anthonyzhou-1/3Dprinting/Z_Shaft_Clamp_v1.2.stl

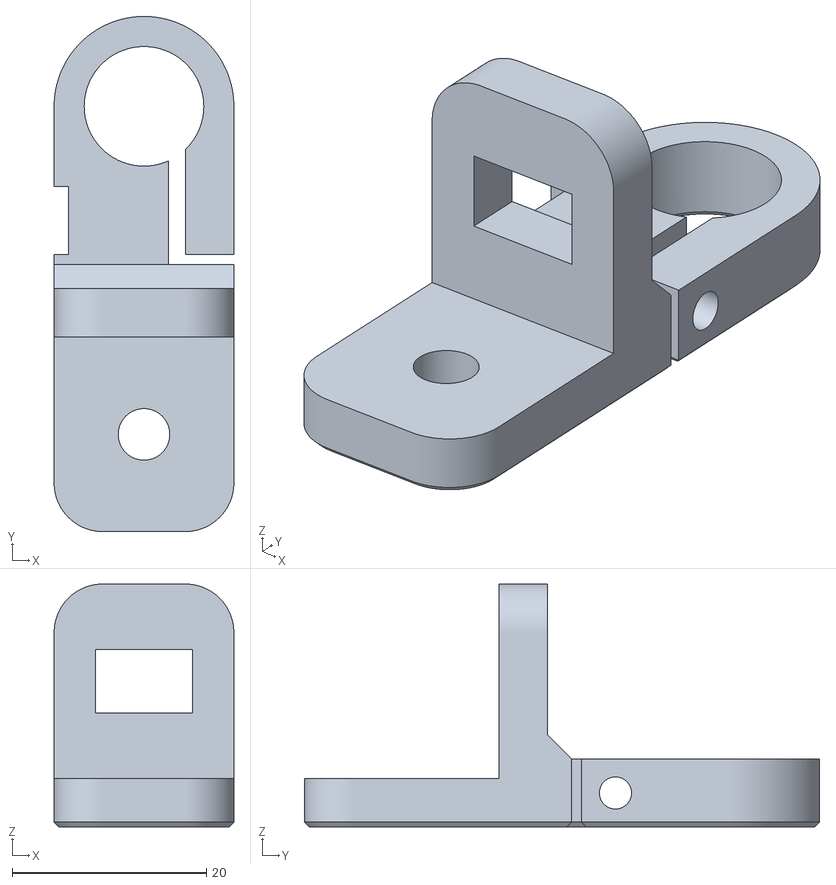
[picture p5: CAD file, 2020-04-30]
Z_Shaft_Clamp_v1.2.stl
18.5 x 53.0 x 25.0
