anthonyzhou-1/3Dprinting/Bowden_Knob.stl

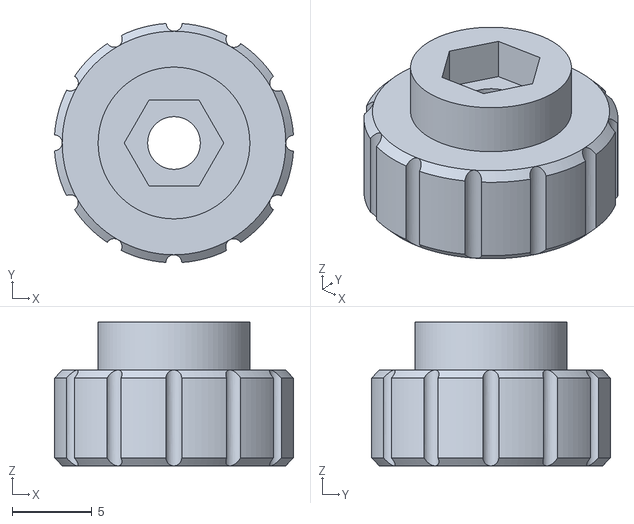
[picture p6: CAD file, 2020-04-30]
Bowden_Knob.stl
15.0 x 15.0 x 9.00
