anthonyzhou-1/3Dprinting/E3D_clamp.stl

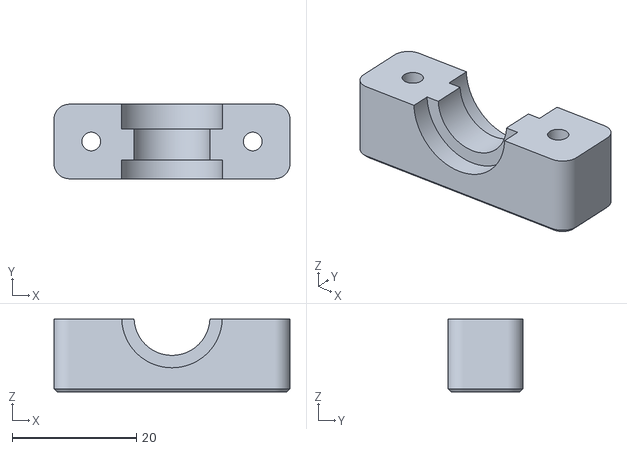
[picture p7: CAD file, 2020-04-30]
E3D_clamp.stl
38.0 x 12.0 x 11.8
