anthonyzhou-1/3Dprinting/Fan_Duct_v1.2.stl

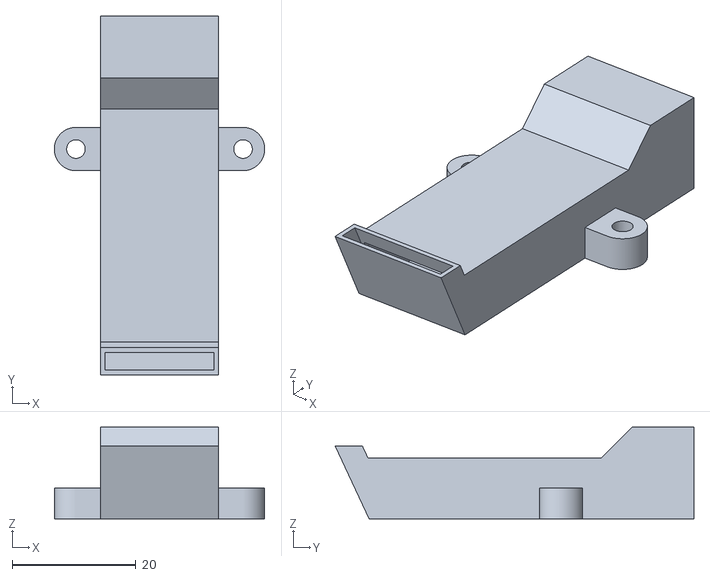
[picture p8: CAD file, 2020-04-30]
Fan_Duct_v1.2.stl
34.0 x 58.0 x 14.8
