anthonyzhou-1/3Dprinting/Z_EndStop_v1.2.stl

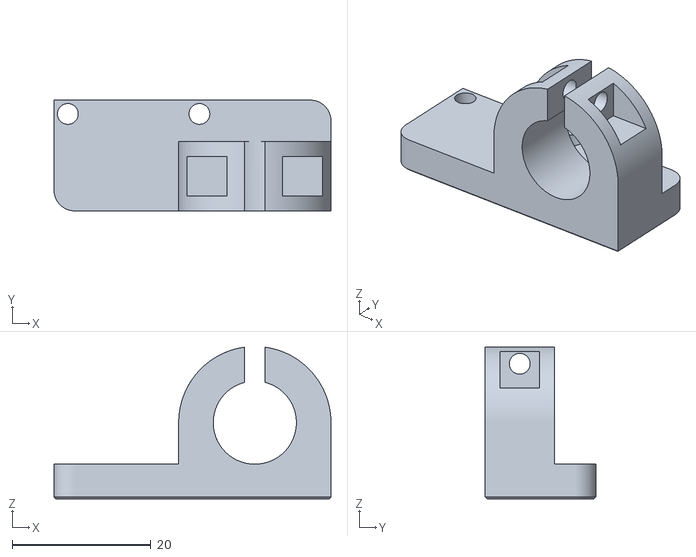
[picture p9: CAD file, 2020-04-30]
Z_EndStop_v1.2.stl
40.0 x 16.0 x 21.9
