anthonyzhou-1/3Dprinting/Z_EndStop_Adjust_v1.1.stl

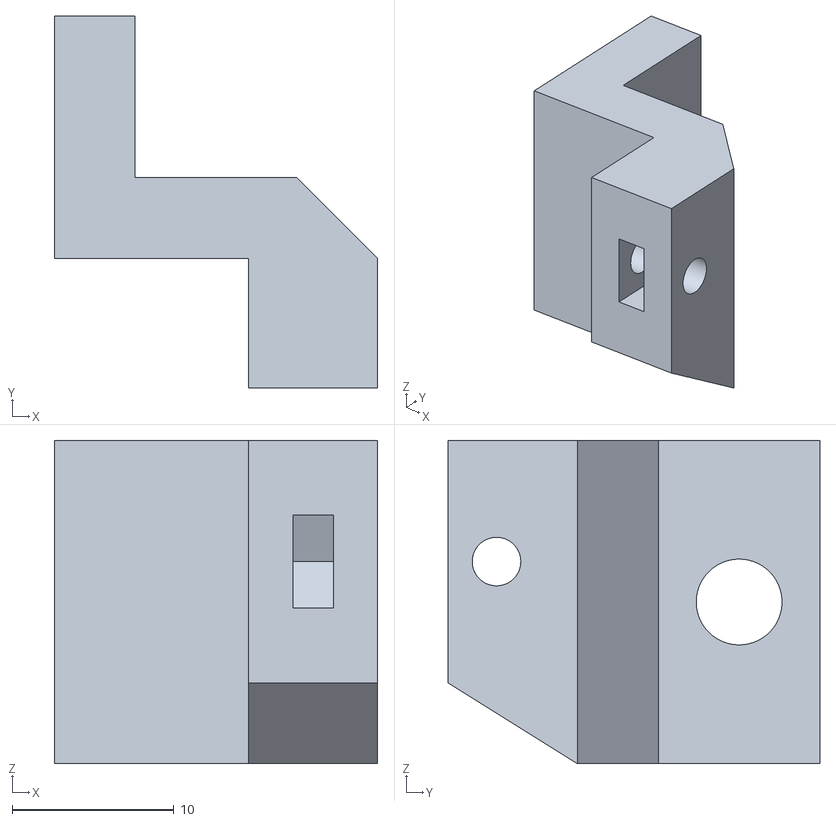
[picture p10: CAD file, 2020-04-30]
Z_EndStop_Adjust_v1.1.stl
20.0 x 23.0 x 20.0
