anthonyzhou-1/3Dprinting/XY_Motor_right.stl

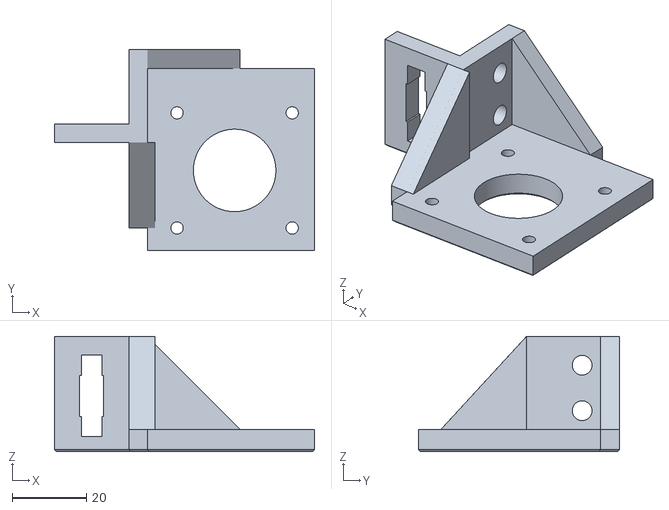
[picture p11: CAD file, 2020-04-30]
XY_Motor_right.stl
70.0 x 54.0 x 31.0
