anthonyzhou-1/3Dprinting/XY_Joiner_v1.1.stl

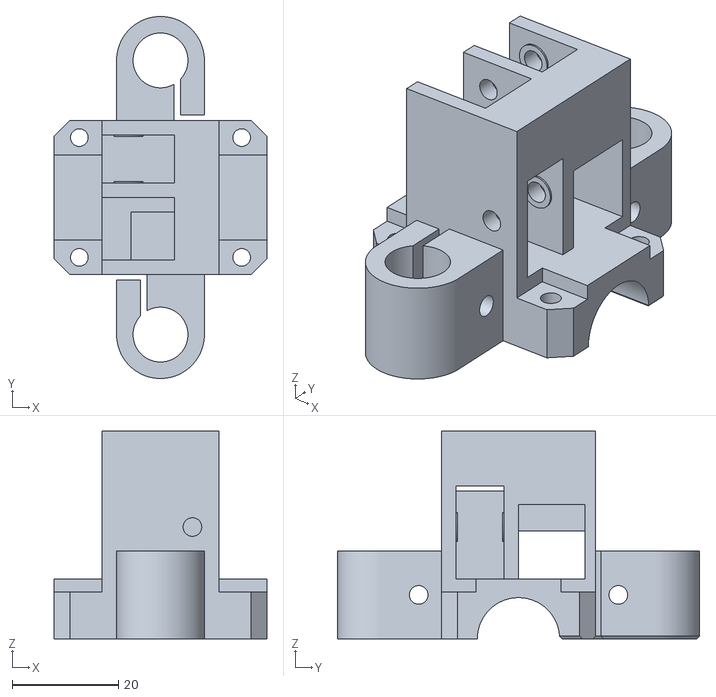
[picture p12: CAD file, 2020-04-30]
XY_Joiner_v1.1.stl
40.0 x 68.0 x 39.0
