anthonyzhou-1/3Dprinting/Y_EndStop.stl

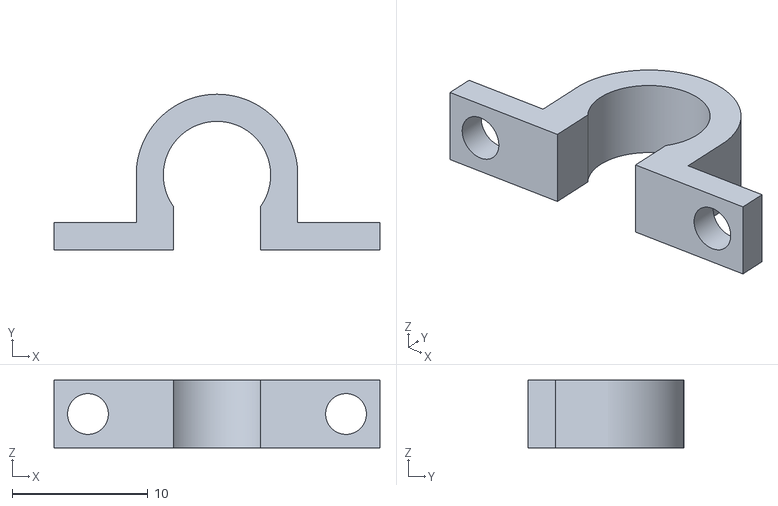
[picture p13: CAD file, 2020-04-30]
Y_EndStop.stl
24.0 x 11.4 x 5.00
