anthonyzhou-1/3Dprinting/X_Carriage_v1.2.stl

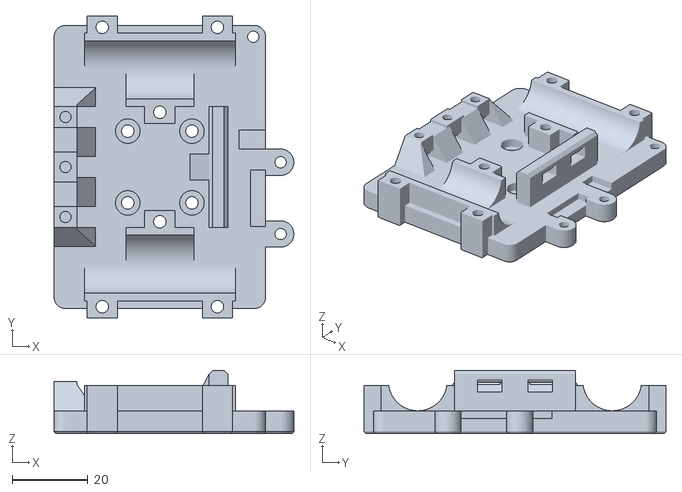
[picture p14: CAD file, 2020-04-30]
X_Carriage_v1.2.stl
63.5 x 80.0 x 16.8
