anthonyzhou-1/3Dprinting/Y_Shaft_Clamp.stl

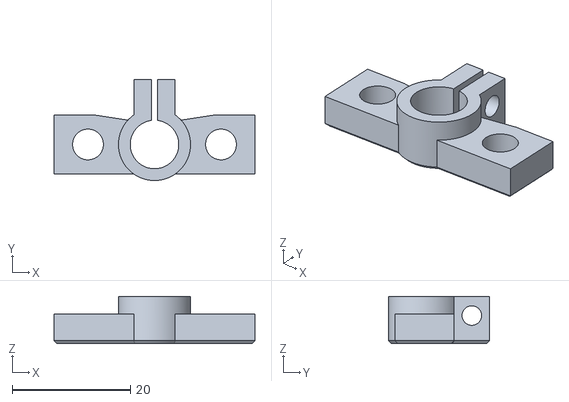
[picture p15: CAD file, 2020-04-30]
Y_Shaft_Clamp.stl
34.0 x 17.1 x 8.00
