anthonyzhou-1/3Dprinting/XY_Clamp_v1.1.stl

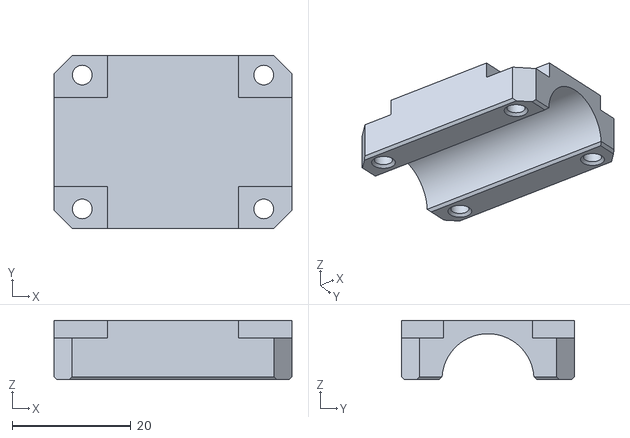
[picture p16: CAD file, 2020-04-30]
XY_Clamp_v1.1.stl
40.0 x 29.0 x 10.0
