anthonyzhou-1/3Dprinting/Z_Motor_v1.1.stl

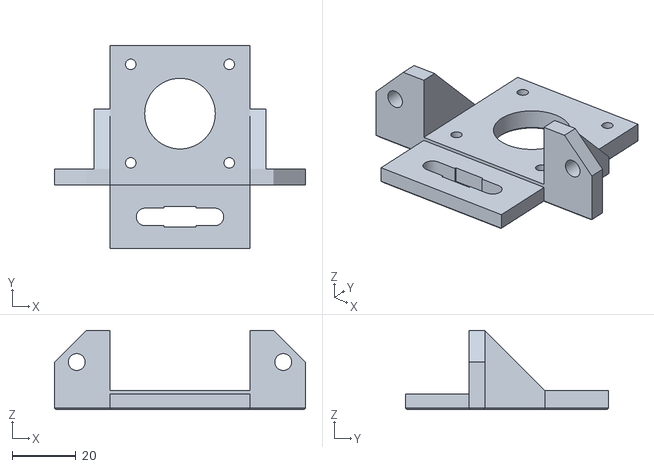
[picture p17: CAD file, 2020-04-30]
Z_Motor_v1.1.stl
79.0 x 64.0 x 25.0
