anthonyzhou-1/3Dprinting/Z_Carriage_clamp_v1.1.stl

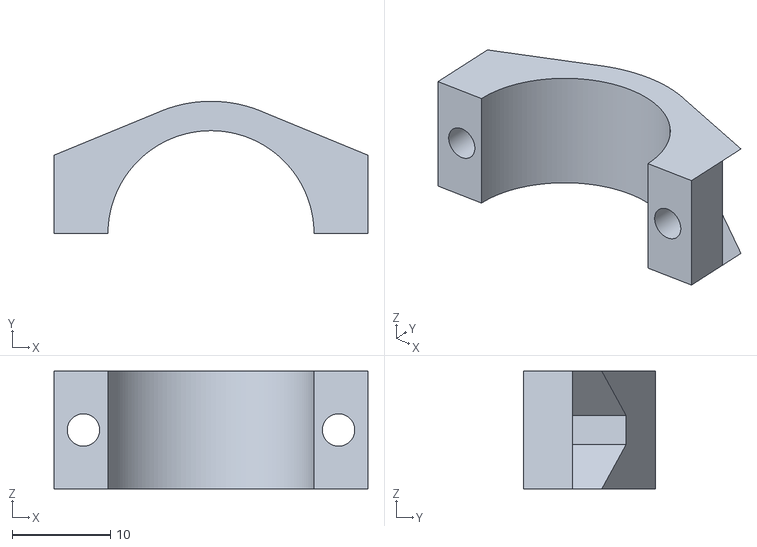
[picture p18: CAD file, 2020-04-30]
Z_Carriage_clamp_v1.1.stl
32.0 x 13.5 x 12.0
