anthonyzhou-1/3Dprinting/Bed_Support_v1.1.stl

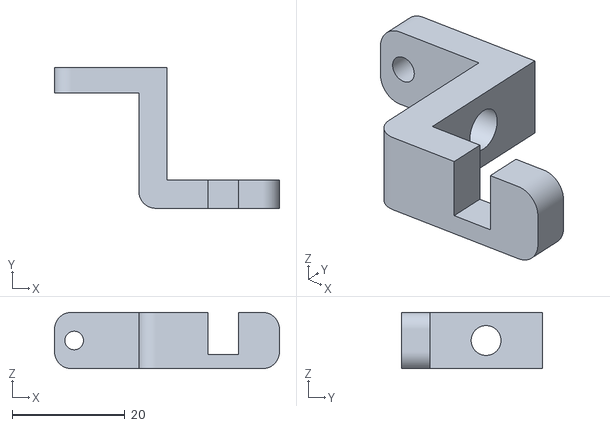
[picture p19: CAD file, 2020-04-30]
Bed_Support_v1.1.stl
40.0 x 25.0 x 10.0
