anthonyzhou-1/3Dprinting/Dual_bushing_holder.stl

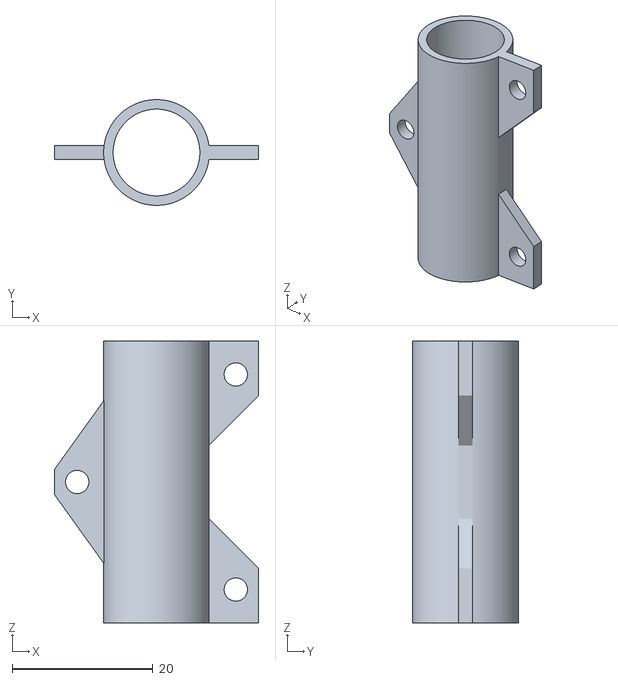
[picture p20: CAD file, 2020-04-30]
Dual_bushing_holder.stl
29.0 x 15.0 x 40.0
