anthonyzhou-1/3Dprinting/Bowden_Motor_v1.1.stl

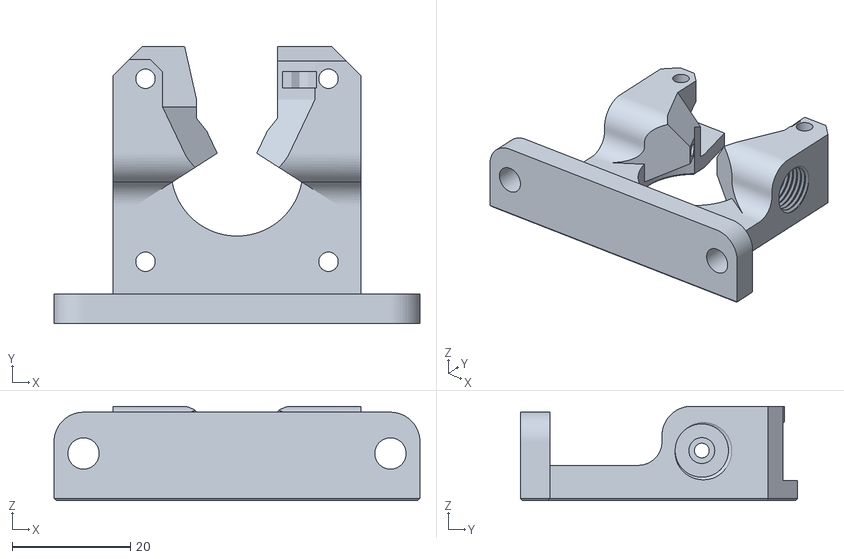
[picture p21: CAD file, 2020-04-30]
Bowden_Motor_v1.1.stl
62.0 x 47.0 x 16.0
