anthonyzhou-1/3Dprinting/Y_Shaft_Clamp_Left_Motor.stl

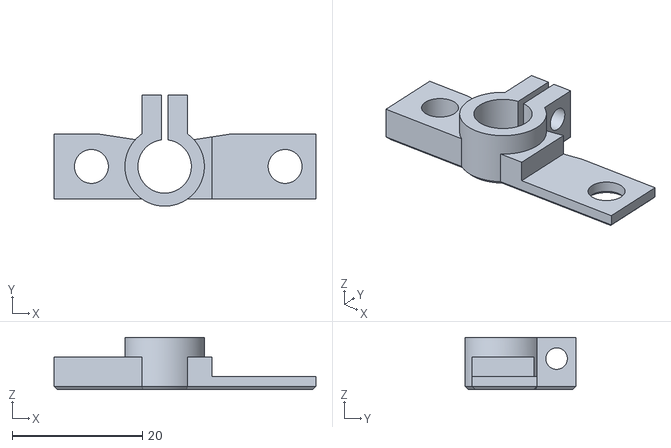
[picture p22: CAD file, 2020-04-30]
Y_Shaft_Clamp_Left_Motor.stl
40.2 x 17.1 x 8.00
