anthonyzhou-1/3Dprinting/E3D_mount_v1.1.stl

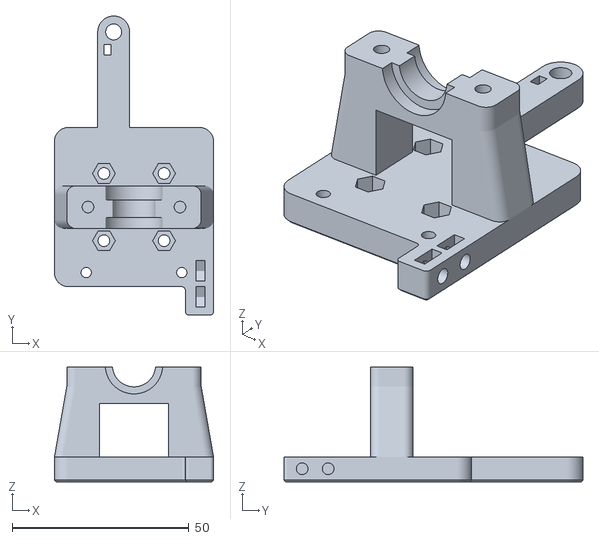
[picture p23: CAD file, 2020-04-30]
E3D_mount_v1.1.stl
45.0 x 84.5 x 32.5
