anthonyzhou-1/3Dprinting/Spool_Axle_Clamp.stl

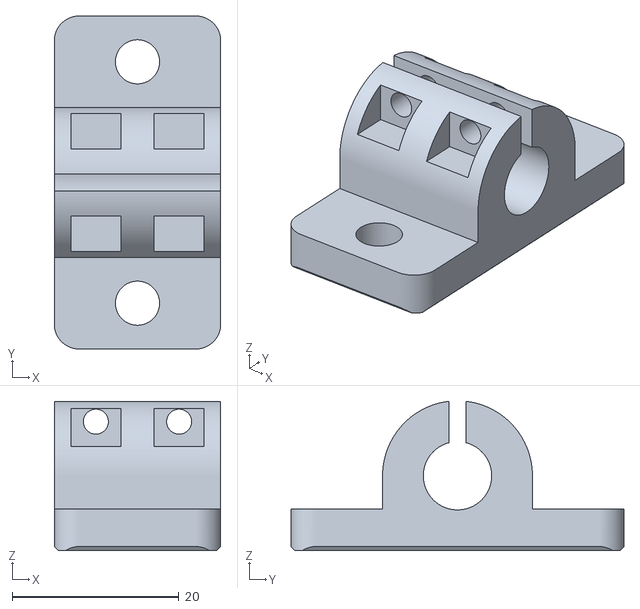
[picture p24: CAD file, 2020-04-30]
Spool_Axle_Clamp.stl
20.0 x 40.0 x 17.9
