anthonyzhou-1/3Dprinting/X_Carriage_beltclamp.stl

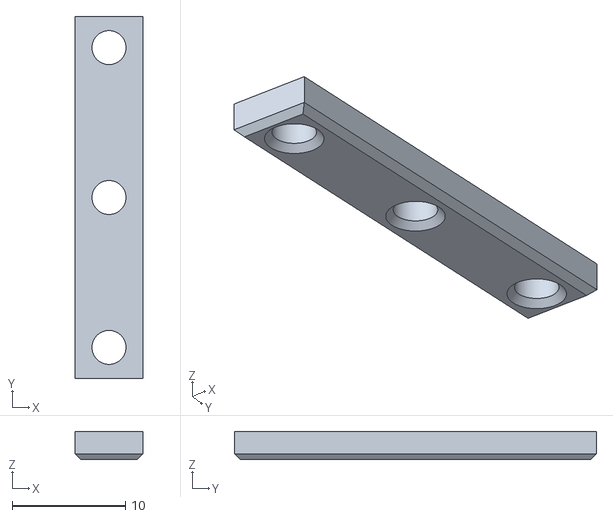
[picture p25: CAD file, 2020-04-30]
X_Carriage_beltclamp.stl
6.00 x 32.0 x 2.50
