anthonyzhou-1/3Dprinting/Z_Carriage_v1.1.stl

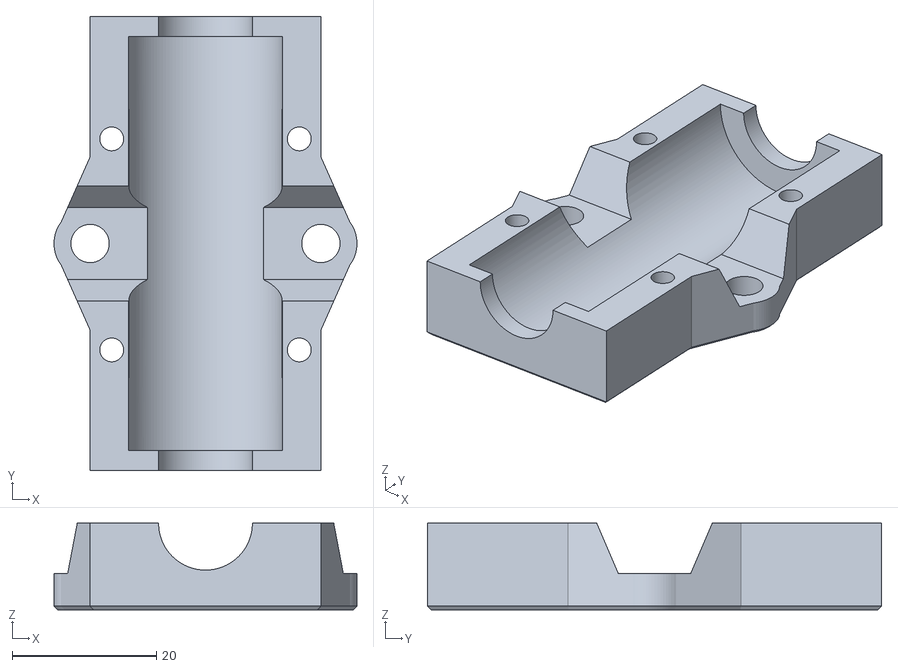
[picture p26: CAD file, 2020-04-30]
Z_Carriage_v1.1.stl
42.0 x 63.0 x 12.0
