anthonyzhou-1/3Dprinting/E3D_sensor_mount_v1.2.stl

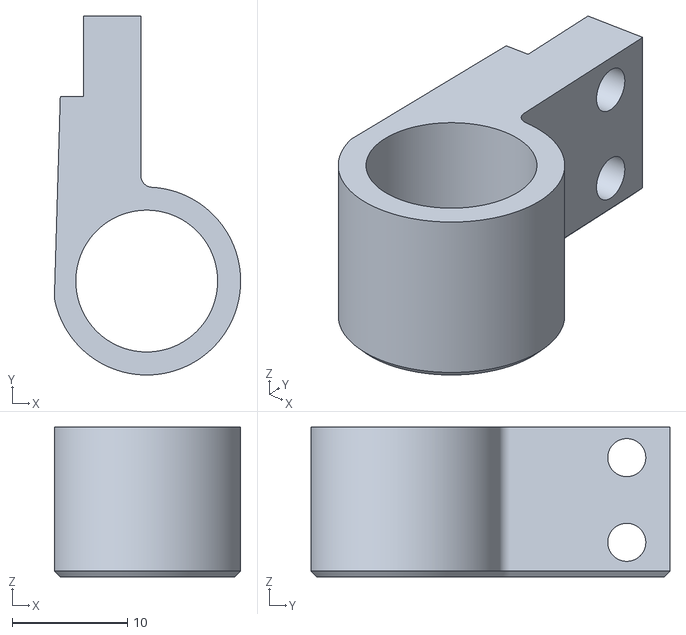
[picture p27: CAD file, 2020-04-30]
E3D_sensor_mount_v1.2.stl
16.2 x 31.1 x 13.0
