anthonyzhou-1/3Dprinting/Bowden_Idler.stl

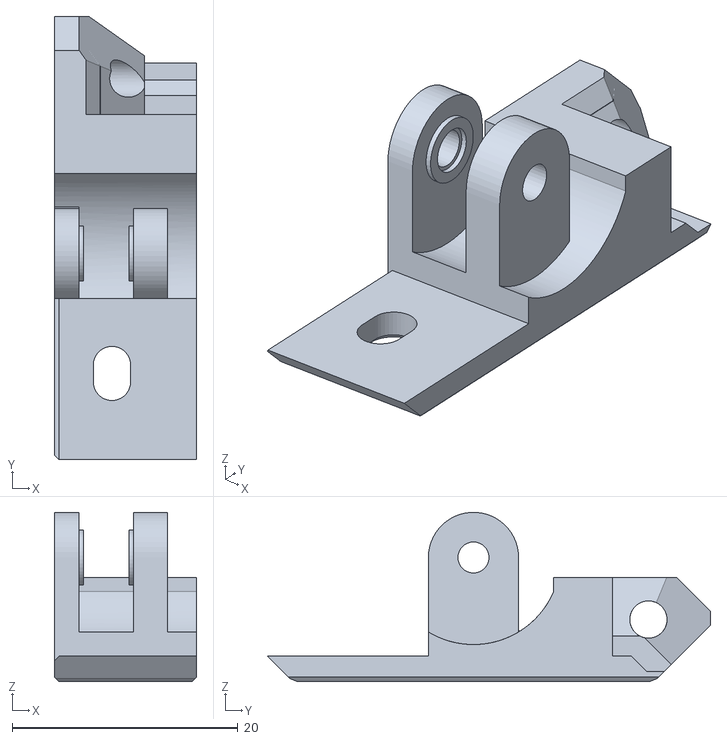
[picture p28: CAD file, 2020-04-30]
Bowden_Idler.stl
12.6 x 39.2 x 15.0
