anthonyzhou-1/3Dprinting/XY_Idler.stl

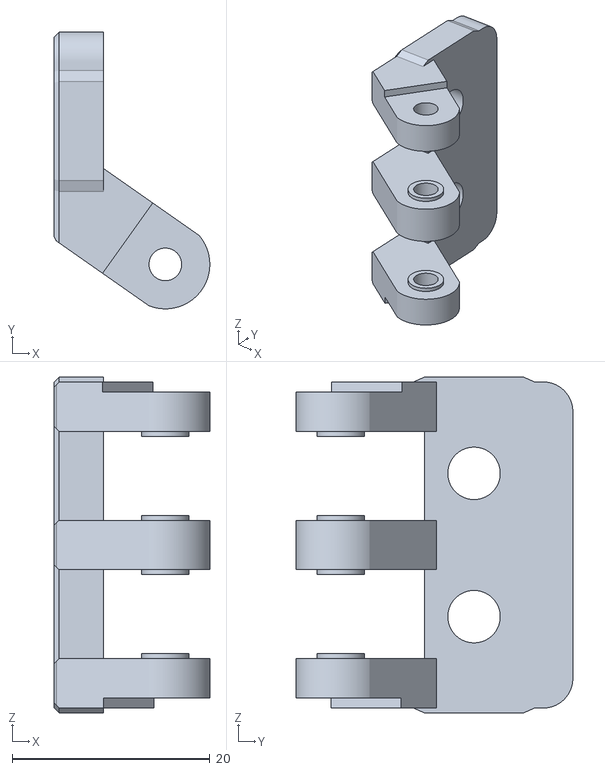
[picture p29: CAD file, 2020-04-30]
XY_Idler.stl
15.7 x 28.0 x 34.0
