anthonyzhou-1/3Dprinting/(list of files, cad)

Other CAD files:
XY_Motor_left.stl
Z_nut_mount_v1.1.stl
